teahaz/TH-1-MO/pcb/MO/v0.1/fabrication/impedence_control.xlsx

Signal Layer | Reference Layer | Impedance Type | Trace Width（mil) | Trace Spacing（mil) | Impedance(ohm)±10% | Position | Notes
L1 | L2 | Differential Pair (Non coplanar) | 4.688 | 7.87 | 100 |  | 5 Separate pairs
L1 | L2 | Differential Pair (Non coplanar) | 5.338 | 5.909 | 90 |  | 5 Separate pairs
L1/L4 | L2/L3 | Differential Pair (Non coplanar) | 5.338 | 5.909 | 90 |  | USB HS differential pairs transition layers via through-hole vias partway along their length: L1 (ref L2) → L4 (ref L3). Same trace width/spacing (5.338/5.909 mil) maintained on both segments. L3 is locally flooded with GND (via-stitched to main ground) beneath the L4 segments, with a brief interruption under the connector. Screenshot shows both segments and the via connecting them. 2 differential pairs.
