teahaz/TH-1-MO/parts/p20/assembly.FCStd

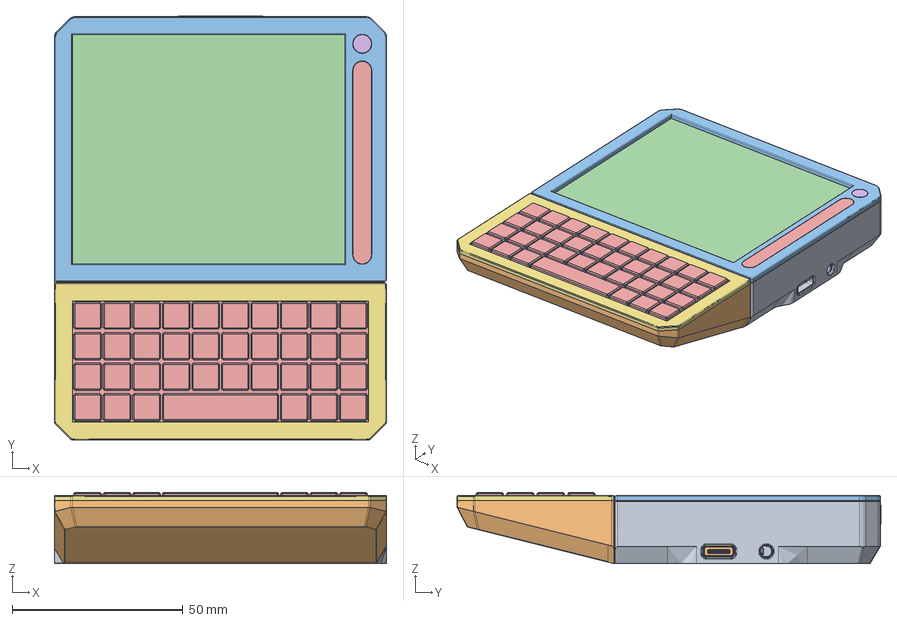
[picture p1: CAD file, 2026-10-23]
parts/p20/assembly.FCStd
97.4 x 124.3 x 20.9 mm
StockShell
StudyCase
Bezel
Screen
LEDDiffuser
IRWindow
StockCarrier
RuntimeCM5
RuntimeCM5Seats
StockCooling
StockFFC
StockDisplayBond
StockIRHarness
IRBoard
IRRx
IRTx
IRBaffle
PCB
SwitchBodies
SwitchActuators
TPUKeymat
LongKeyInsert
RetainingFrame
LEDStrip
LEDs
LEDConnector
LEDPlug
LEDWires
DisplaySocketBody
DisplaySocketLatch
DisplaySocketContacts
Card0
Card1
Card0USB
Card1USB
Card0Plug
Card1Plug
AudioBody
AudioFlex
USBPads
RightUSBShell
RightUSBInsulator
RightUSBContacts
Host0Shell
Host0Insulator
Host0Contacts
Host1Shell
Host1Insulator
Host1Contacts
PScrew0
PScrew1
PNut0
PNut1
PSeatPad0
PSeatPad1
KScrew0
KScrew1
KNut0
KNut1
KSeatPad0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
