teahaz/TH-1-MO/parts/p22/exterior-print/assembly.FCStd

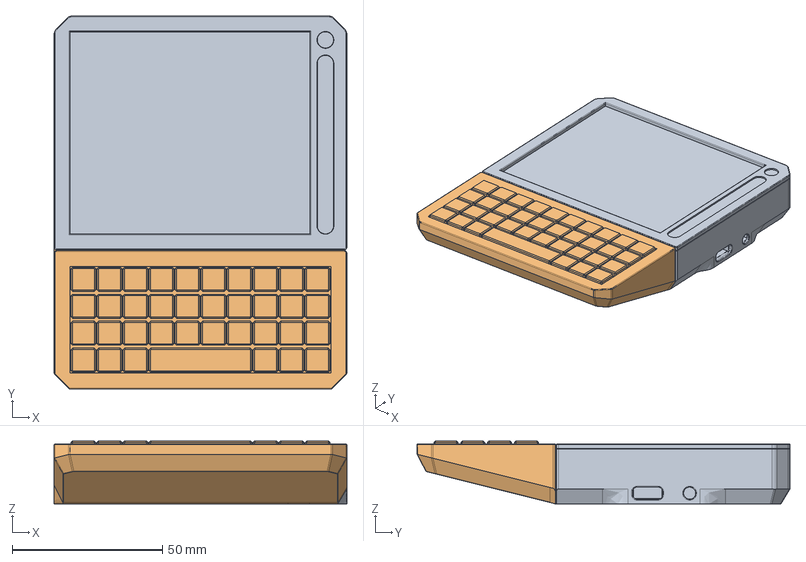
[picture p2: CAD file, 2026-10-23]
parts/p22/exterior-print/assembly.FCStd
97.4 x 124.1 x 20.9 mm
Puck
Keyboard
