teahaz/TH-1-MO/parts/p19/assembled.step

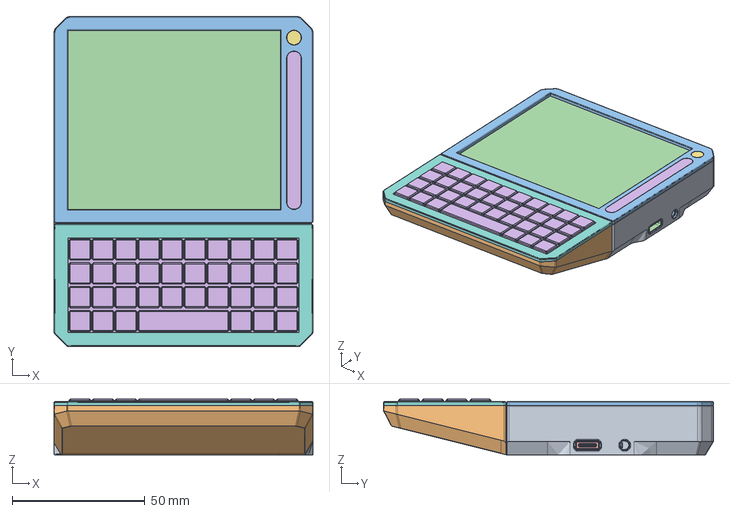
[picture p3: CAD file, 2026-10-19]
parts/p19/assembled.step
97.4 x 124.1 x 20.9 mm
