teahaz/TH-1-MO/parts/p12/stl/03_hat_with_antennae.stl

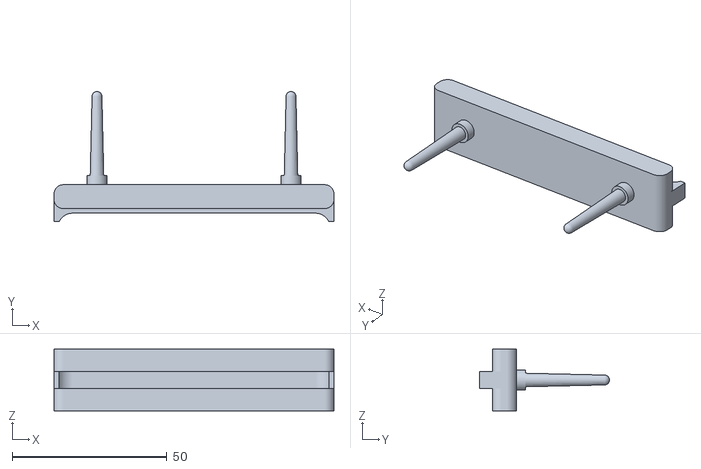
[picture p4: CAD file, 2026-10-11]
parts/p12/stl/03_hat_with_antennae.stl
90.4 x 42.0 x 20.0
