teahaz/TH-1-MO/parts/p15/P15.FCStd

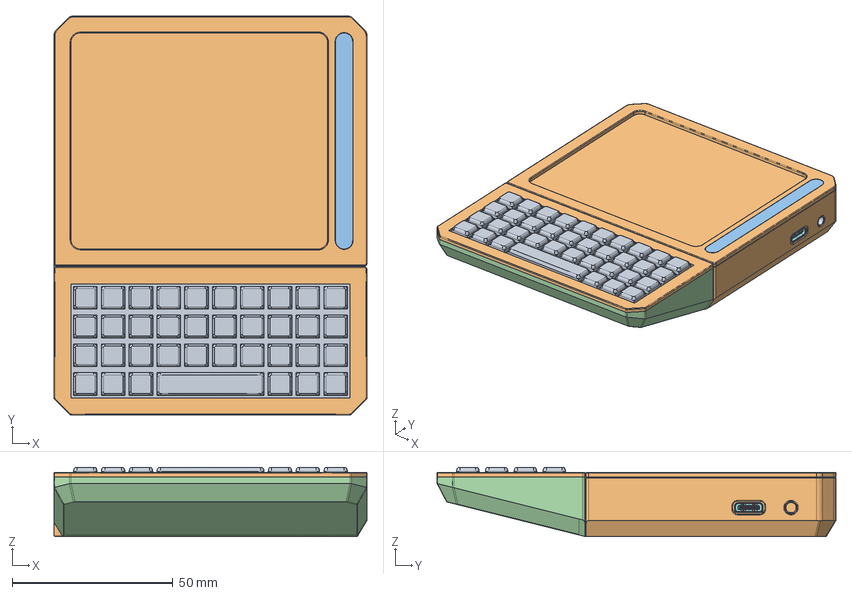
[picture p5: CAD file, 2026-10-19]
parts/p15/P15.FCStd
97.4 x 124.1 x 21.5 mm
Puck shell
Bezel
Screen
Card0
Card1
Card0USB
Card1USB
FixedUSB
AudioJack
Puck
Flush white diffuser (mounting and electronics TBD)
Case
PCB
SwitchBodies
SwitchActuators
LongKeyInsert
TPUKeymat
RetainingFrame
