teahaz/TH-1-MO/parts/p15/stl/06_led_diffuser.stl

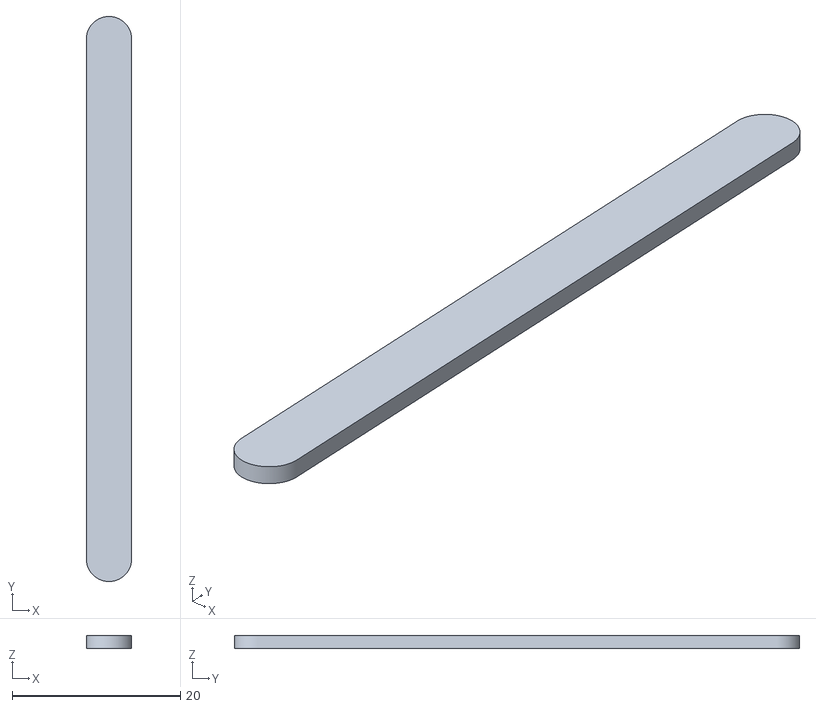
[picture p6: CAD file, 2026-10-19]
parts/p15/stl/06_led_diffuser.stl
5.40 x 67.2 x 1.50
