teahaz/TH-1-MO/parts/p16/P16.FCStd

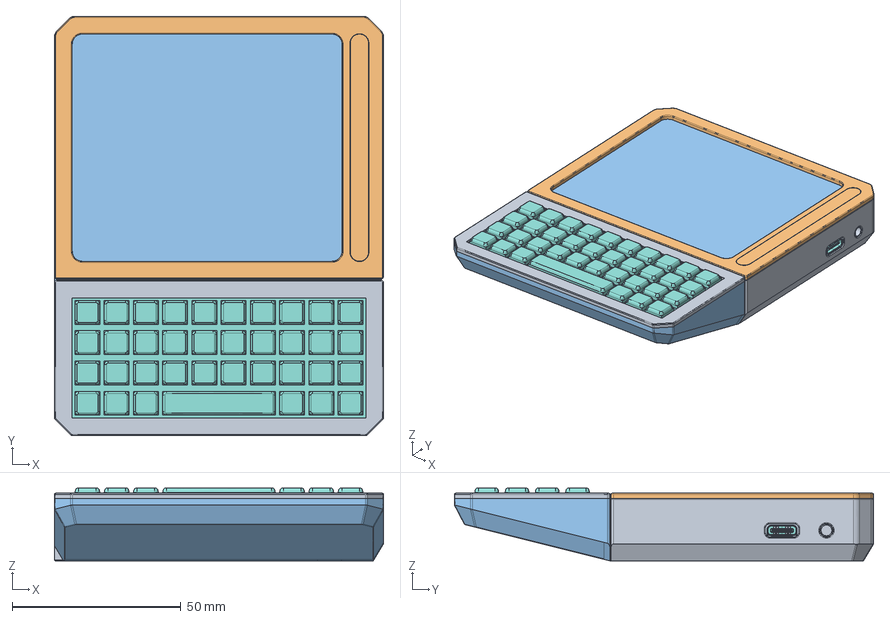
[picture p7: CAD file, 2026-10-19]
parts/p16/P16.FCStd
97.4 x 124.1 x 21.5 mm
Bezel
Screen
Card0
Card1
Card0USB
Card1USB
FixedUSB
AudioJack
LEDDiffuser
Case
PCB
SwitchBodies
SwitchActuators
LongKeyInsert
TPUKeymat
RetainingFrame
PScrew0
PNut0
PScrew1
PNut1
PHookPad0
PHookPad1
KScrew0
KNut0
KScrew1
KNut1
KHookPad0
KHookPad1
