teahaz/TH-1-MO/parts/p16/stl/05_tpu_keymat.stl

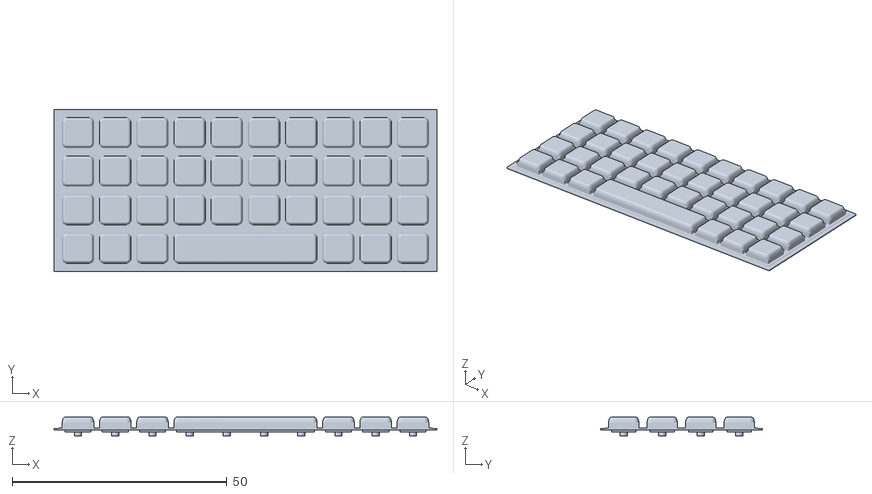
[picture p8: CAD file, 2026-10-19]
parts/p16/stl/05_tpu_keymat.stl
89.1 x 37.8 x 4.35
