teahaz/TH-1-MO/parts/p17/P17.FCStd

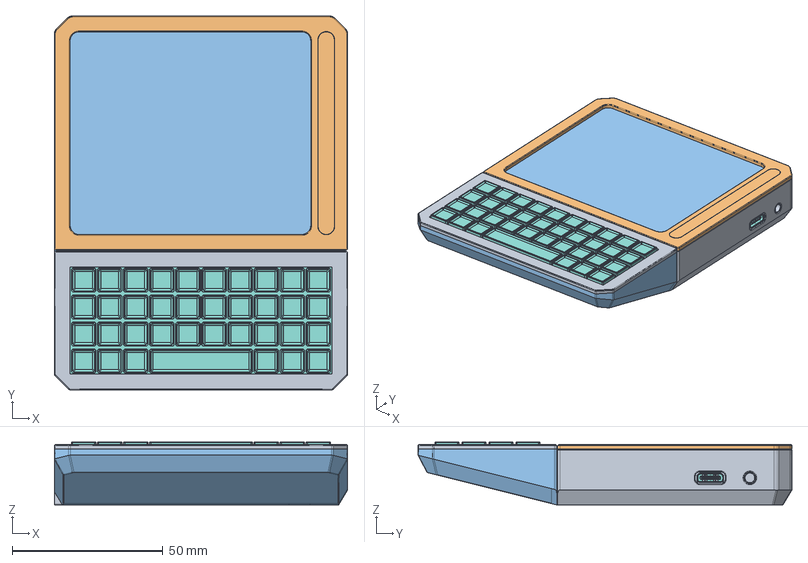
[picture p9: CAD file, 2026-10-19]
parts/p17/P17.FCStd
97.4 x 124.1 x 20.9 mm
Bezel
Screen
Card0
Card1
Card0USB
Card1USB
FixedUSB
AudioJack
LEDDiffuser
Case
PCB
SwitchBodies
SwitchActuators
LongKeyInsert
TPUKeymat
RetainingFrame
PScrew0
PNut0
PScrew1
PNut1
PSeatPad0
PSeatPad1
KScrew0
KNut0
KScrew1
KNut1
KSeatPad0
KSeatPad1
