teahaz/TH-1-MO/parts/p18/stl/05_tpu_keymat.stl

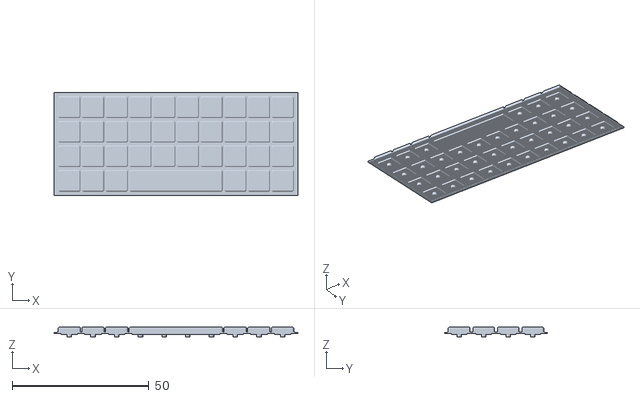
[picture p11: CAD file, 2026-10-19]
parts/p18/stl/05_tpu_keymat.stl
89.1 x 37.8 x 3.75
