teahaz/TH-1-MO/parts/p19/assembled/RetainingFrame.stl

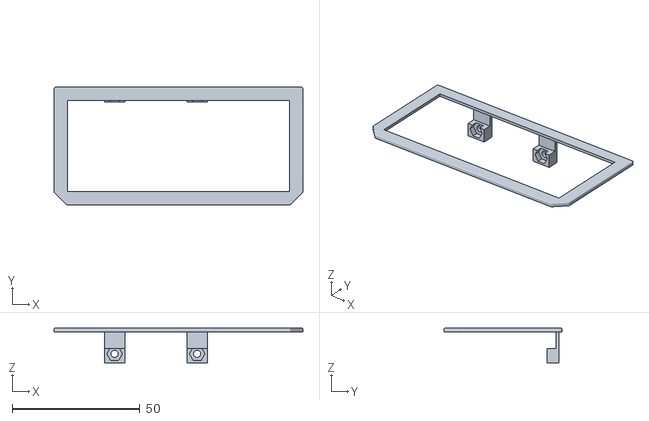
[picture p12: CAD file, 2026-10-19]
parts/p19/assembled/RetainingFrame.stl
97.4 x 46.1 x 13.5
