teahaz/TH-1-MO/parts/p19/internals/PCIePads.stl

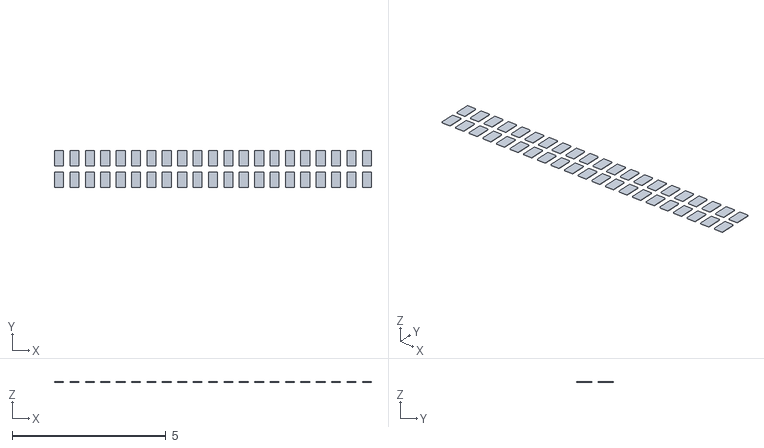
[picture p13: CAD file, 2026-10-19]
parts/p19/internals/PCIePads.stl
10.3 x 1.20 x 0.035
