teahaz/TH-1-MO/parts/p22/exterior-print/print/stl/puck.stl

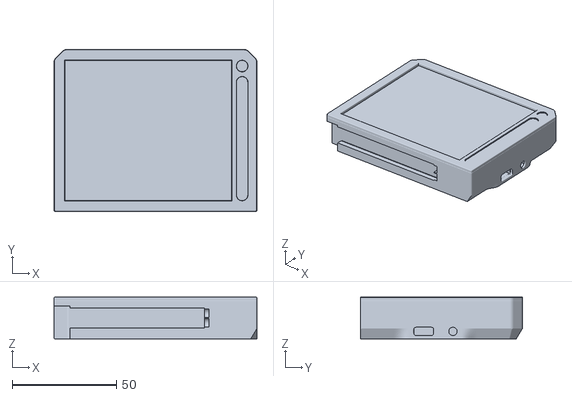
[picture p14: CAD file, 2026-10-23]
parts/p22/exterior-print/print/stl/puck.stl
97.4 x 77.8 x 20.0
