teahaz/TH-1-MO/parts/p15/stl/02_keyboard_case.stl

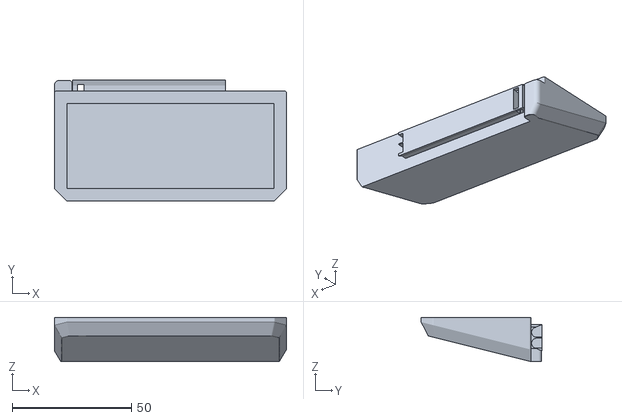
[picture p15: CAD file, 2026-10-19]
parts/p15/stl/02_keyboard_case.stl
97.4 x 50.7 x 18.5
