teahaz/TH-1-MO/parts/p17/stl/01_puck_shell.stl

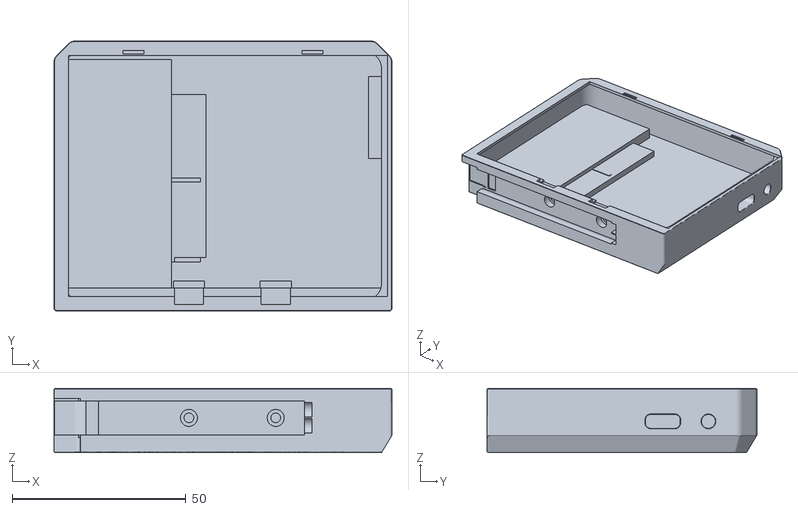
[picture p16: CAD file, 2026-10-19]
parts/p17/stl/01_puck_shell.stl
97.4 x 77.8 x 18.5
