teahaz/TH-1-MO/parts/p18/stl/01_puck_shell.stl

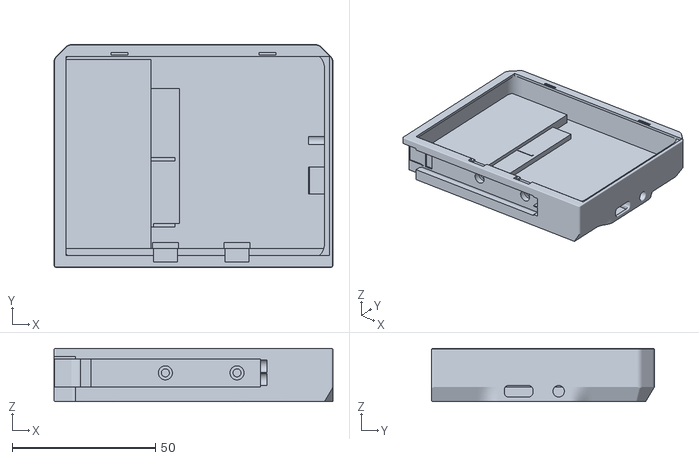
[picture p17: CAD file, 2026-10-19]
parts/p18/stl/01_puck_shell.stl
97.4 x 77.8 x 18.5
