teahaz/TH-1-MO/parts/p19/assembled/NokiaBattery.stl

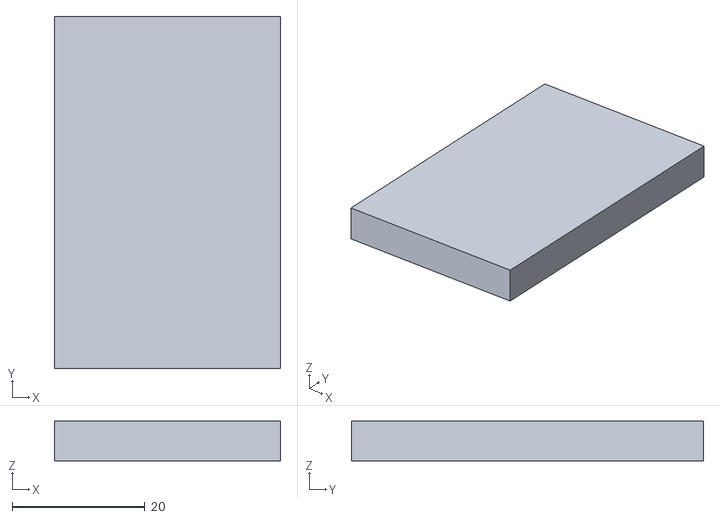
[picture p18: CAD file, 2026-10-19]
parts/p19/assembled/NokiaBattery.stl
34.0 x 53.0 x 6.00
