teahaz/TH-1-MO/parts/p19/internals/RuntimeCM5.stl

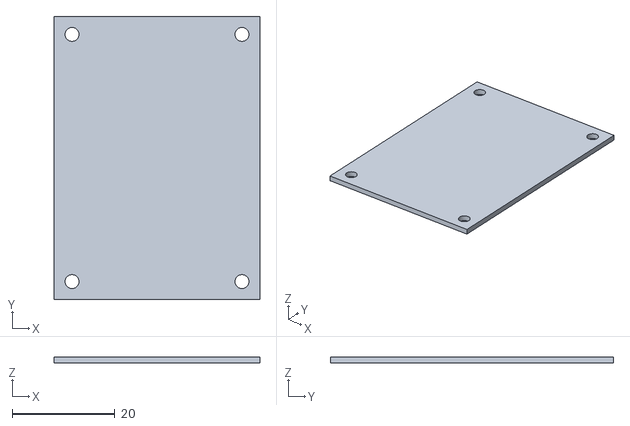
[picture p19: CAD file, 2026-10-19]
parts/p19/internals/RuntimeCM5.stl
40.0 x 55.0 x 1.24
