teahaz/TH-1-MO/parts/p22/exterior-print/print/stl/keyboard.stl

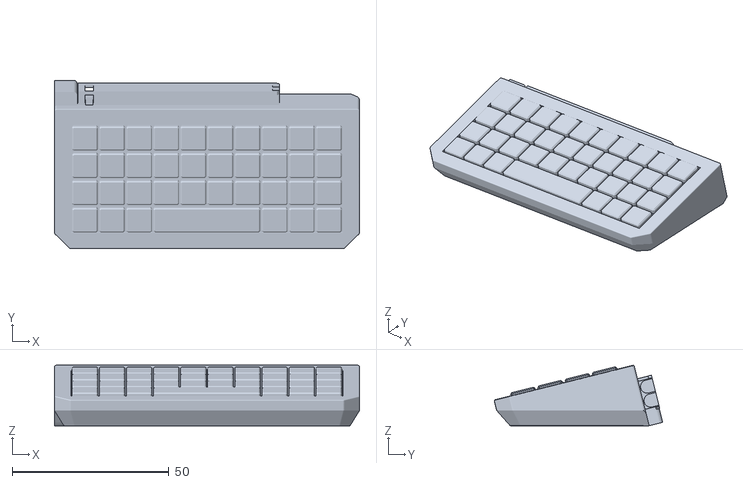
[picture p20: CAD file, 2026-10-23]
parts/p22/exterior-print/print/stl/keyboard.stl
97.4 x 53.8 x 19.4
