teahaz/TH-1-MO/parts/p16/stl/04_keyboard_frame.stl

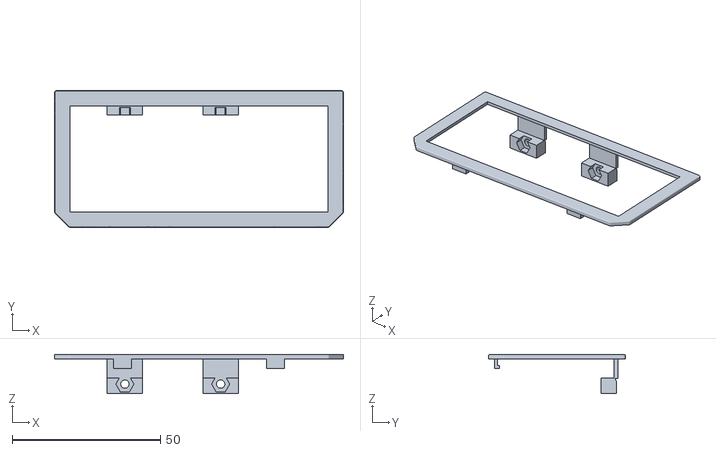
[picture p21: CAD file, 2026-10-19]
parts/p16/stl/04_keyboard_frame.stl
97.4 x 46.1 x 13.2
