teahaz/TH-1-MO/parts/p17/stl/02_puck_bezel.stl

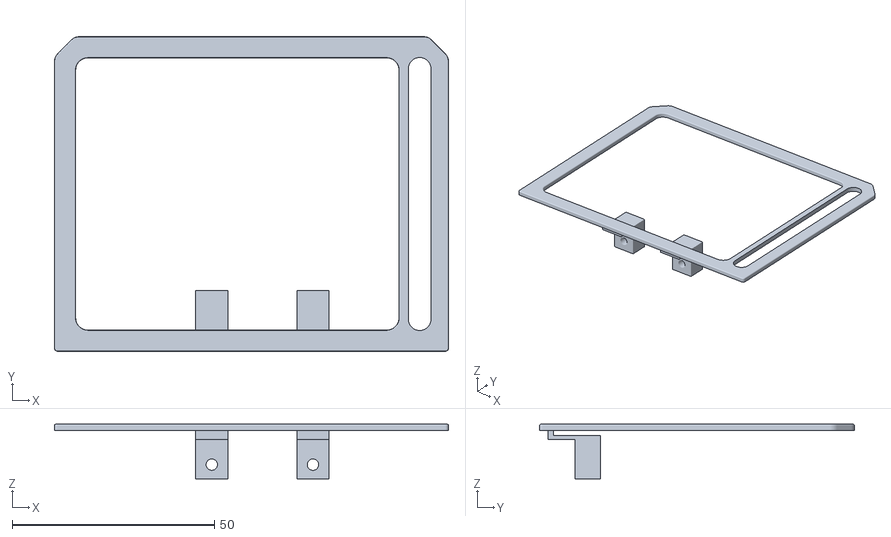
[picture p22: CAD file, 2026-10-19]
parts/p17/stl/02_puck_bezel.stl
97.4 x 77.8 x 13.5
