teahaz/TH-1-MO/parts/p19/assembled/LEDPlug.stl

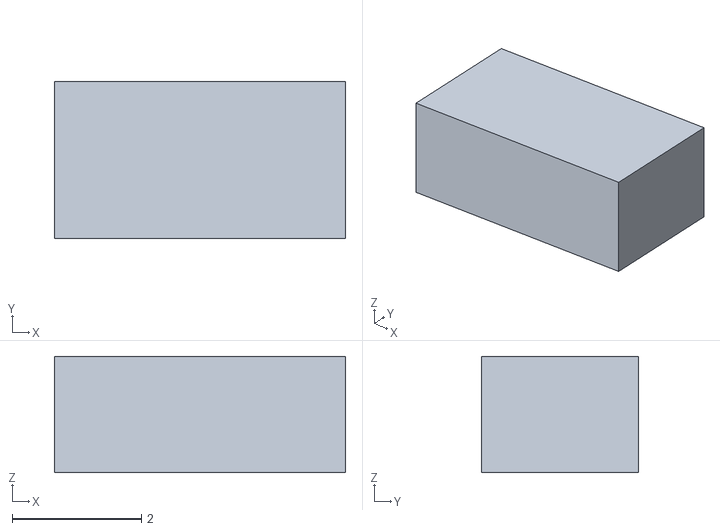
[picture p23: CAD file, 2026-10-19]
parts/p19/assembled/LEDPlug.stl
4.50 x 2.43 x 1.80
