teahaz/TH-1-MO/parts/p19/internals/IRRx.stl

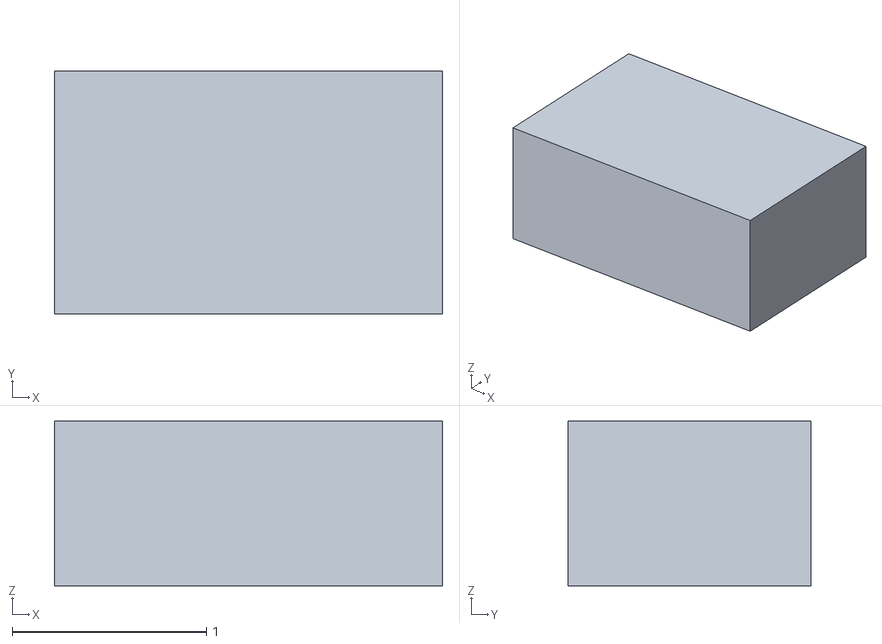
[picture p24: CAD file, 2026-10-19]
parts/p19/internals/IRRx.stl
2.00 x 1.25 x 0.85
