teahaz/TH-1-MO/parts/p19/internals/StockCooling.stl

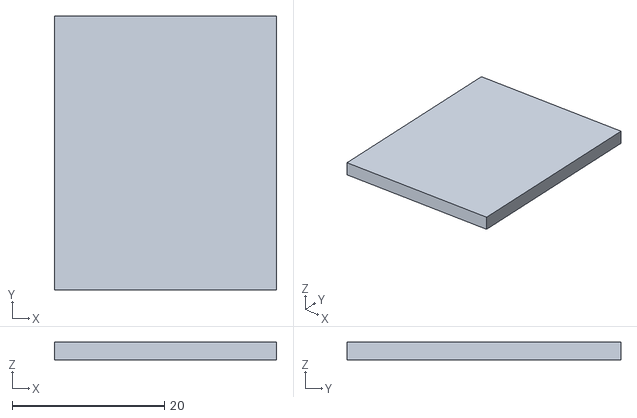
[picture p25: CAD file, 2026-10-19]
parts/p19/internals/StockCooling.stl
29.2 x 36.0 x 2.30
