teahaz/TH-1-MO/parts/p16/stl/02_puck_bezel.stl

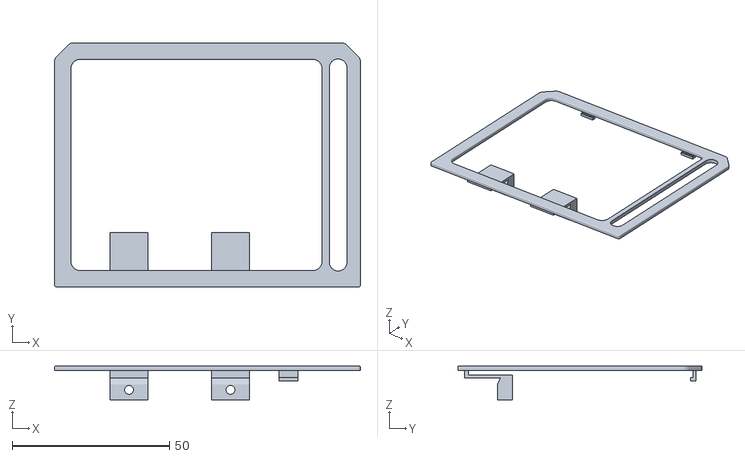
[picture p26: CAD file, 2026-10-19]
parts/p16/stl/02_puck_bezel.stl
97.4 x 77.8 x 10.8
