teahaz/TH-1-MO/parts/p19/assembled/IRWindow.stl

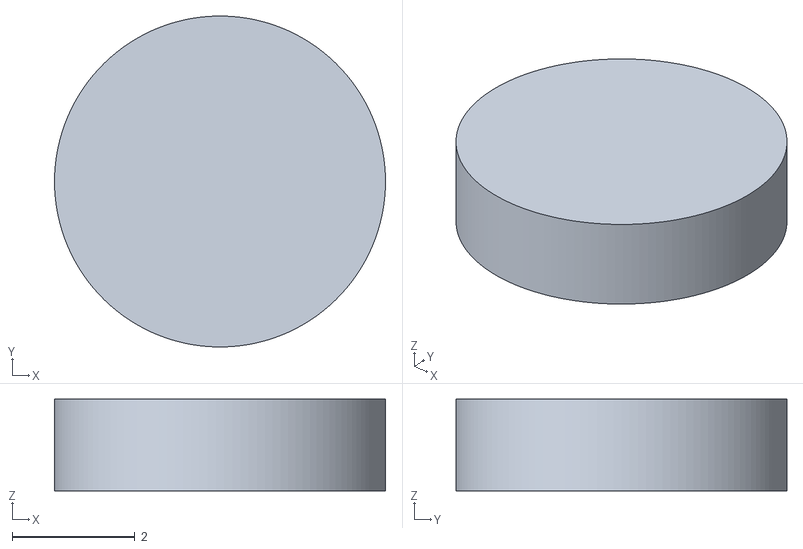
[picture p27: CAD file, 2026-10-19]
parts/p19/assembled/IRWindow.stl
5.40 x 5.40 x 1.50
