teahaz/TH-1-MO/parts/p19/internals/USBPads.stl

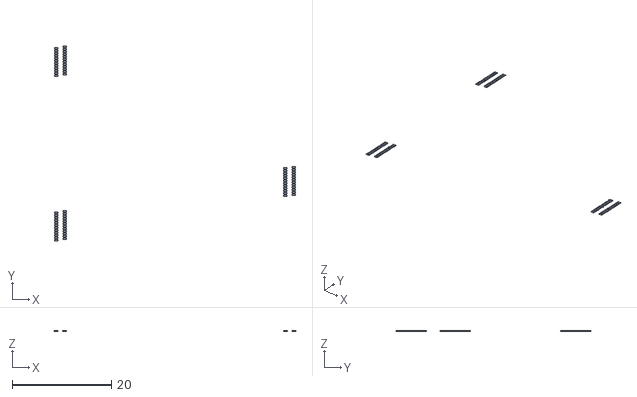
[picture p28: CAD file, 2026-10-19]
parts/p19/internals/USBPads.stl
48.4 x 39.1 x 0.035
