teahaz/TH-1-MO/parts/p19/assembled/Host0Contacts.stl

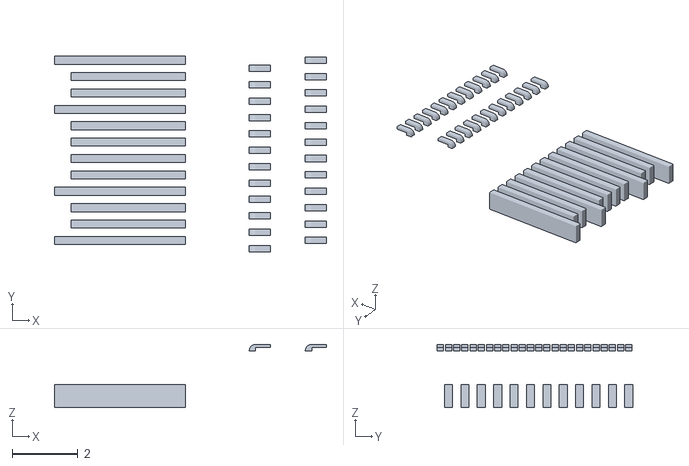
[picture p29: CAD file, 2026-10-19]
parts/p19/assembled/Host0Contacts.stl
8.30 x 5.98 x 1.93
