teahaz/TH-1-MO/parts/p19/internals/StockFFC.stl

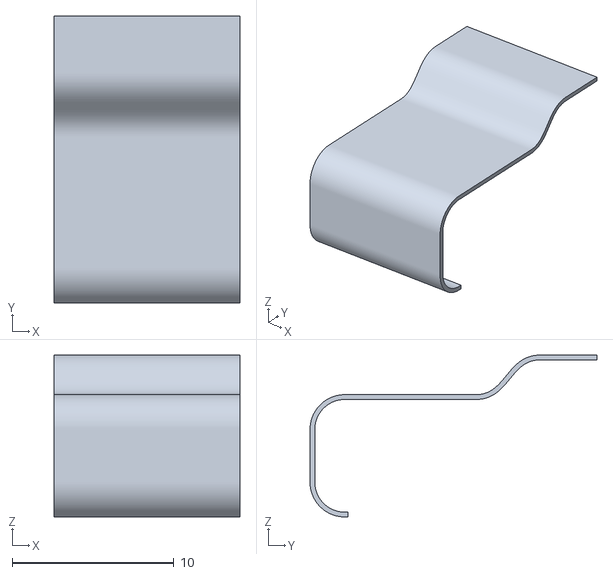
[picture p30: CAD file, 2026-10-19]
parts/p19/internals/StockFFC.stl
11.5 x 17.8 x 10.0
