teahaz/TH-1-MO/parts/p19/assembled/LongKeyInsert.stl

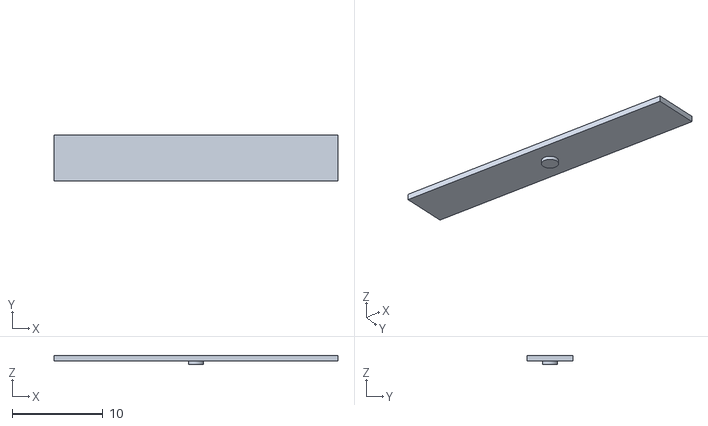
[picture p31: CAD file, 2026-10-19]
parts/p19/assembled/LongKeyInsert.stl
31.4 x 5.09 x 0.95
