teahaz/TH-1-MO/parts/p19/internals/Host1Insulator.stl

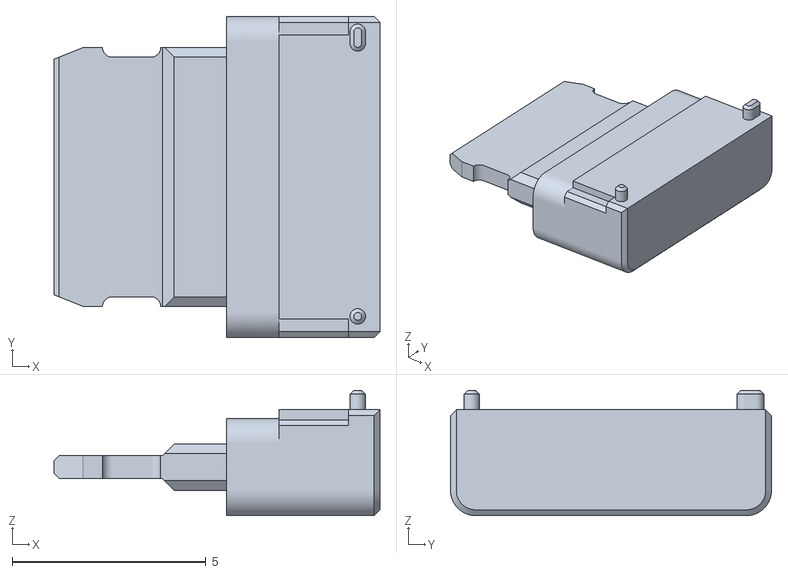
[picture p32: CAD file, 2026-10-19]
parts/p19/internals/Host1Insulator.stl
8.41 x 8.29 x 3.23
