teahaz/TH-1-MO/parts/p19/assembled/Card0.stl

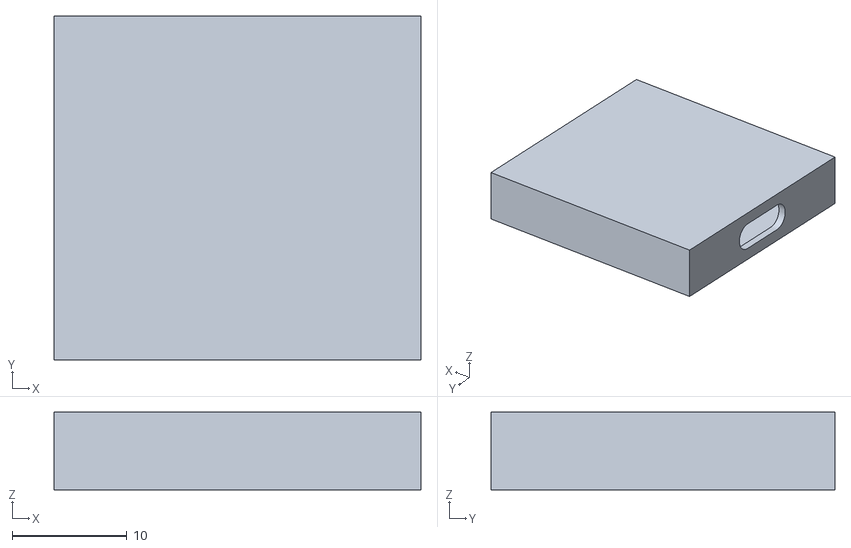
[picture p33: CAD file, 2026-10-19]
parts/p19/assembled/Card0.stl
32.0 x 30.0 x 6.80
