teahaz/TH-1-MO/parts/p19/internals/StockCarrier.stl

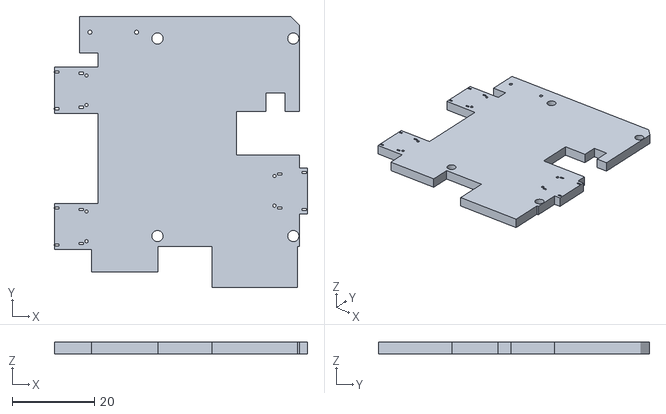
[picture p34: CAD file, 2026-10-19]
parts/p19/internals/StockCarrier.stl
61.6 x 65.8 x 2.88
