teahaz/TH-1-MO/parts/p19/assembled/KNut1.stl

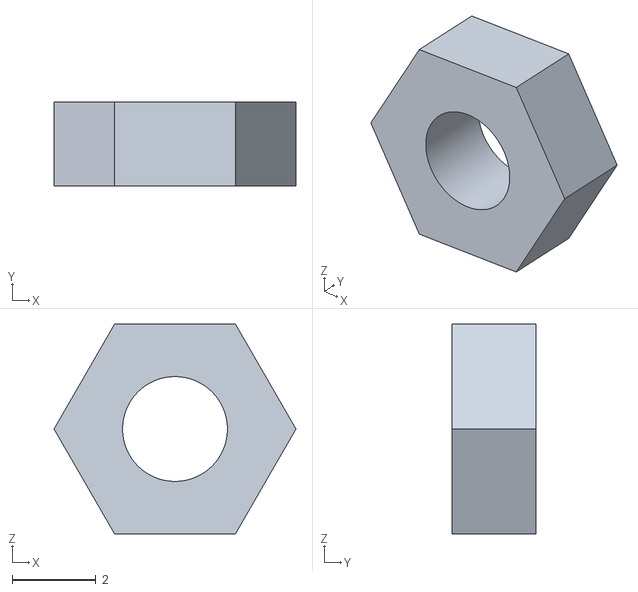
[picture p35: CAD file, 2026-10-19]
parts/p19/assembled/KNut1.stl
5.77 x 2.00 x 5.00
