teahaz/TH-1-MO/parts/p19/internals/Card0Plug.stl

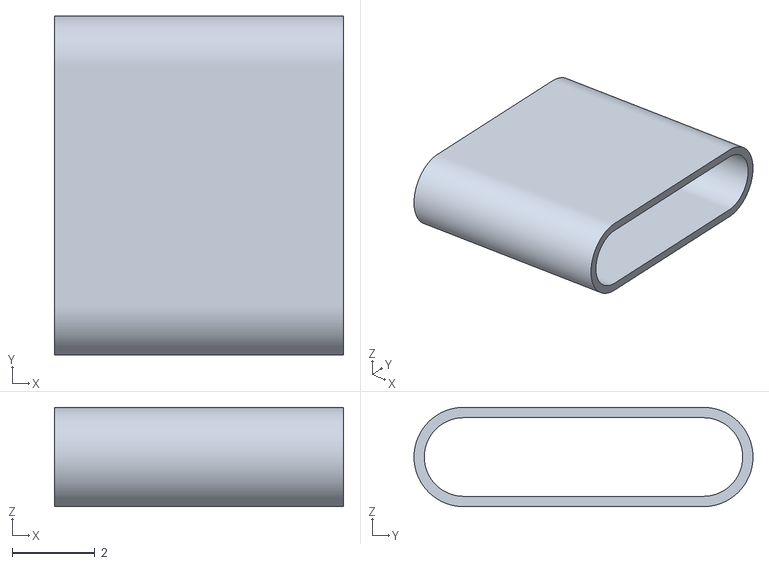
[picture p36: CAD file, 2026-10-19]
parts/p19/internals/Card0Plug.stl
7.00 x 8.20 x 2.40
