teahaz/TH-1-MO/parts/p19/assembled/Host0Shell.stl

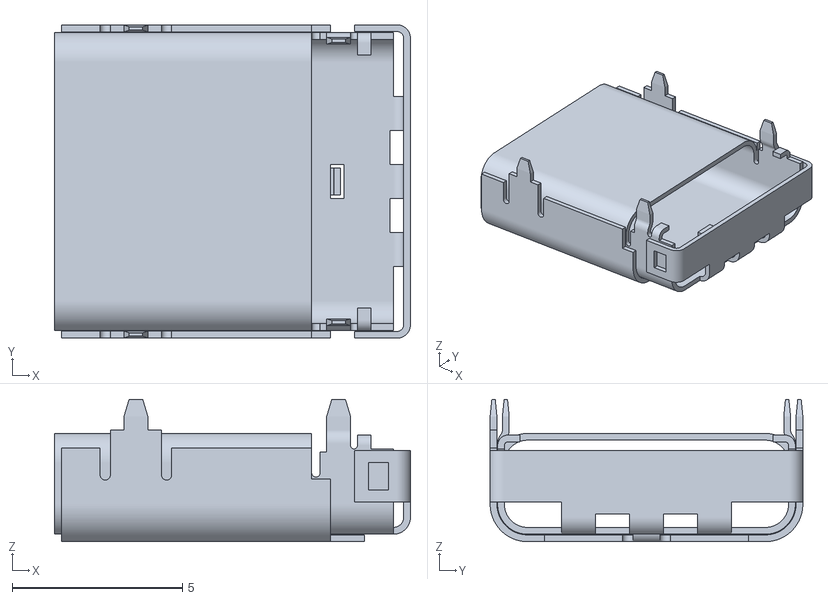
[picture p37: CAD file, 2026-10-19]
parts/p19/assembled/Host0Shell.stl
10.5 x 9.20 x 4.18
