teahaz/TH-1-MO/parts/p19/internals/IRBoard.stl

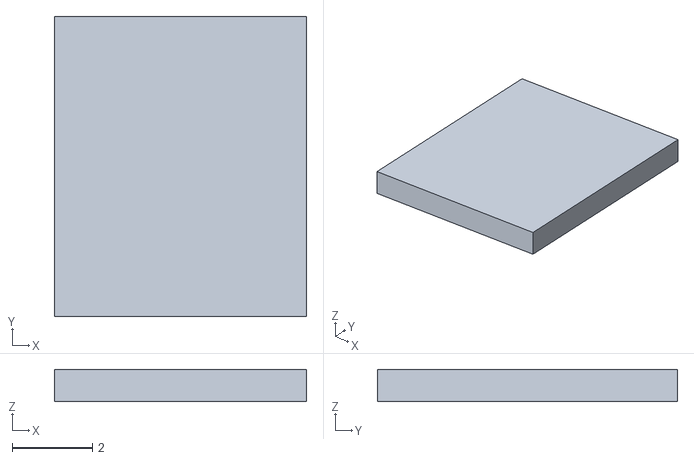
[picture p38: CAD file, 2026-10-19]
parts/p19/internals/IRBoard.stl
6.30 x 7.50 x 0.8
