teahaz/TH-1-MO/parts/p19/assembled/LEDs.stl

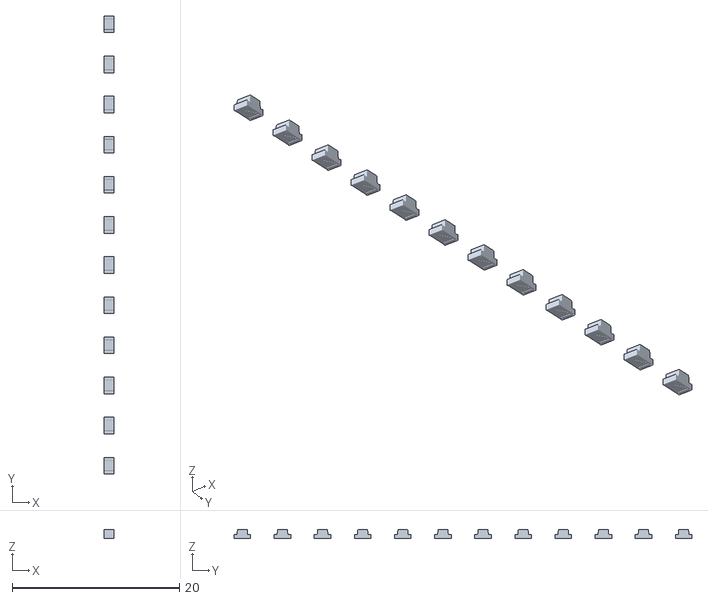
[picture p39: CAD file, 2026-10-19]
parts/p19/assembled/LEDs.stl
1.25 x 54.8 x 1.10
