teahaz/TH-1-MO/parts/p19/internals/KSeatPad1.stl

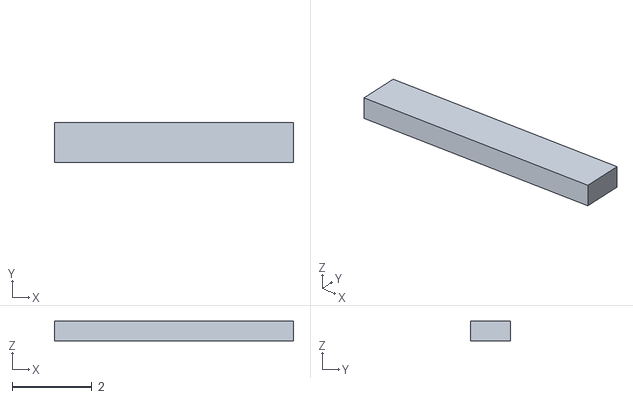
[picture p40: CAD file, 2026-10-19]
parts/p19/internals/KSeatPad1.stl
6.00 x 1.00 x 0.5
