teahaz/TH-1-MO/parts/p19/assembled/AudioBody.stl

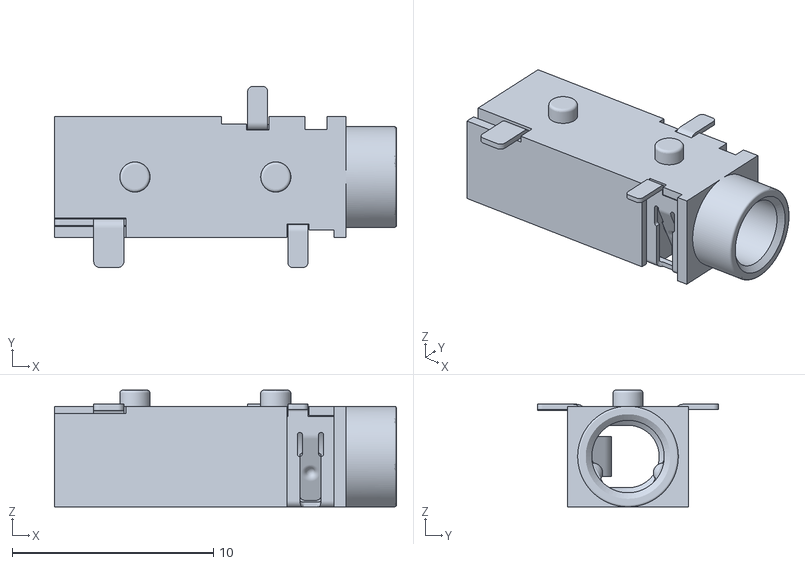
[picture p41: CAD file, 2026-10-19]
parts/p19/assembled/AudioBody.stl
17.0 x 9.00 x 5.80
