teahaz/TH-1-MO/parts/p19/internals/PCIeInsulator.stl

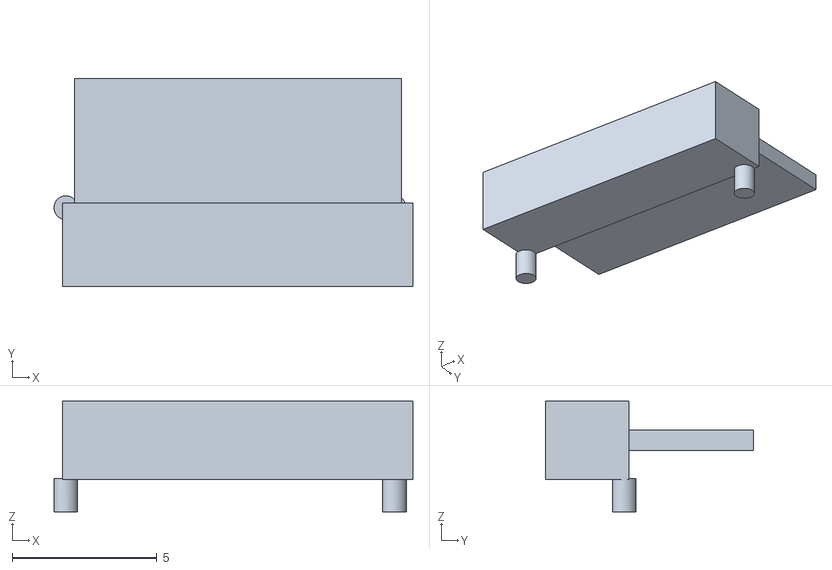
[picture p42: CAD file, 2026-10-19]
parts/p19/internals/PCIeInsulator.stl
12.4 x 7.20 x 3.82
