teahaz/TH-1-MO/parts/p19/assembled/NokiaPad.stl

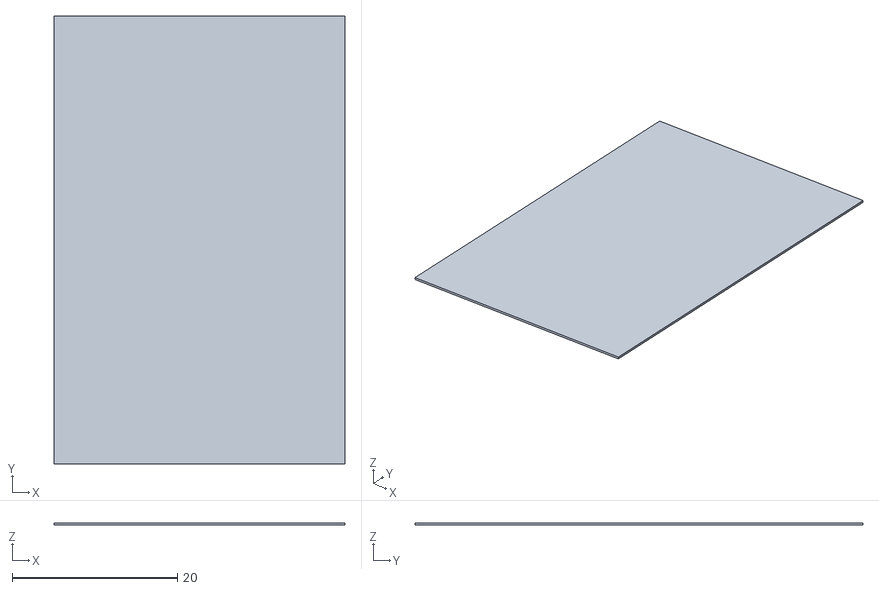
[picture p43: CAD file, 2026-10-19]
parts/p19/assembled/NokiaPad.stl
35.2 x 54.2 x 0.3
