teahaz/TH-1-MO/parts/p19/internals/DisplaySocketContacts.stl

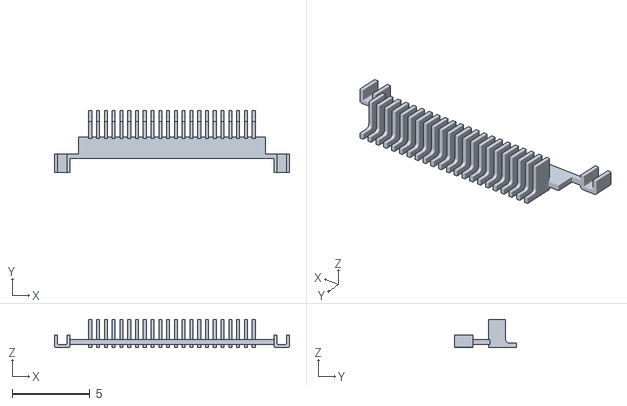
[picture p44: CAD file, 2026-10-19]
parts/p19/internals/DisplaySocketContacts.stl
15.1 x 4.00 x 1.80
