teahaz/TH-1-MO/parts/p19/assembled/Screen.stl

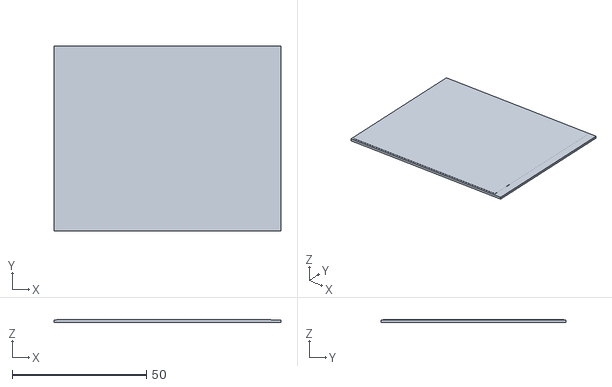
[picture p45: CAD file, 2026-10-19]
parts/p19/assembled/Screen.stl
84.6 x 69.1 x 1.10
