teahaz/TH-1-MO/parts/p19/assembled/LEDDiffuser.stl

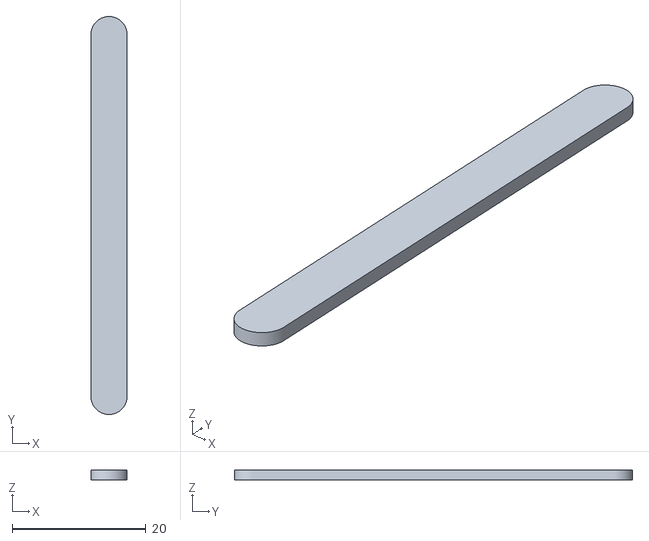
[picture p46: CAD file, 2026-10-19]
parts/p19/assembled/LEDDiffuser.stl
5.40 x 59.4 x 1.50
