teahaz/TH-1-MO/parts/p19/internals/StockIRHarness.stl

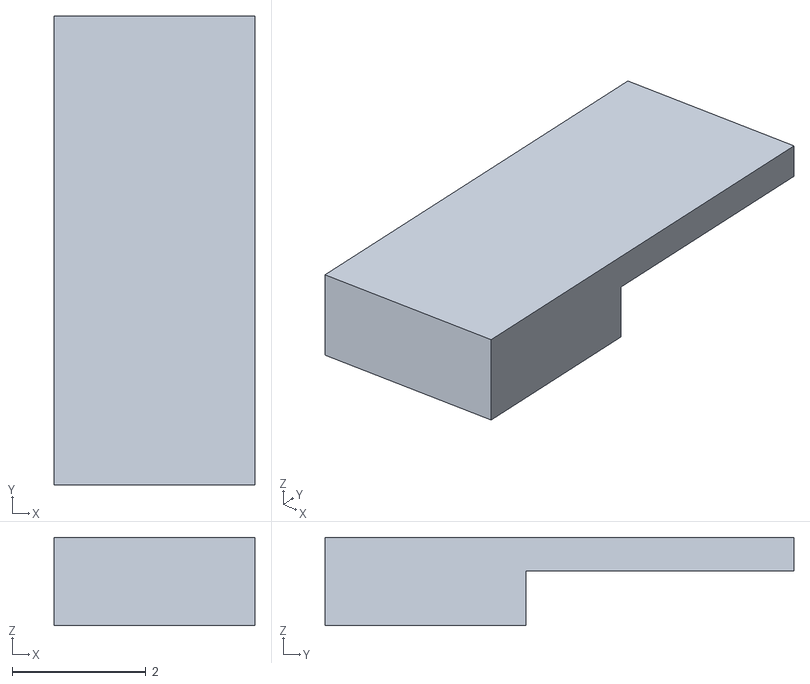
[picture p47: CAD file, 2026-10-19]
parts/p19/internals/StockIRHarness.stl
3.00 x 7.00 x 1.32
