teahaz/TH-1-MO/parts/p1/TH-A1OC_keyboard.scad

// TH-A1OC: Basic keyboard module
include <parts.scad>

translate([CASE_THICKNESS+MODULE_MARGIN, FPT_D, CASE_THICKNESS+MODULE_MARGIN])
    Keyboard();
