teahaz/TH-1-MO/parts/p5/modules/keyboard.scad

KB_W = 80;
KB_D = 6.6;
KB_H = 50;

module _kb_stl() {
    mirror([0, 0, 0])
        rotate([90, 0, 0])
        translate([-25, 87, 0])
        color("#343434")
        import("modules/keyboard.stl", $fn=2);
}

module Keyboard(space=0, cutout=false) {
    align = space == 0 ? 0 : (space - KB_W) / 2;

    translate([align, 1.6, 0]) {
        if (cutout) cube([KB_W, KB_D, KB_H]);
        else _kb_stl();
    }
}
