teahaz/TH-1-MO/parts/p1/TH-A1OC_all.scad

// TH-A1OC: All parts for debug prints
include <parts.scad>

SOLID_SHELL = true;

include <TH-A1OC_shell.scad>
include <TH-A1OC_core.scad>
include <TH-A1OC_frontplate.scad>
include <TH-A1OC_keyboard.scad>
include <TH-A1OC_modules.scad>

Externals(fw=false);
