teahaz/TH-1-MO/parts/p1/TH-A1OC_core.scad

// TH-A1OC: Core (inner shell)
include <parts.scad>

render() difference() {
    union() {
        Internals();
    }
    Externals(cutout=true);
    ExpansionBay(cutout=true);
}
