teahaz/TH-1-MO/parts/p1/TH-A1OC_frontplate.scad

// TH-A1OC: Frontplate
include <parts.scad>

color("white") translate([CASE_THICKNESS, e, CASE_THICKNESS]) Frontplate();
