teahaz/TH-1-MO/(list of files, cad)

Other CAD files:
parts/p21/assembly.FCStd
parts/p22/assembly.FCStd
parts/p18/P18.FCStd
parts/p19/P19.FCStd
parts/p16/stl/03_keyboard_case.stl
parts/p15/stl/04_tpu_keymat.stl
parts/p16/stl/01_puck_shell.stl
parts/p19/assembled/StockShell.stl
parts/p19/internals/Card1Plug.stl
parts/p19/assembled/KSeatPad0.stl
parts/p19/internals/PSeatPad1.stl
parts/p19/assembled/RightUSBShell.stl
parts/p19/assembled/Host1Shell.stl
parts/p19/internals/RightUSBInsulator.stl
parts/p19/assembled/Card1.stl
parts/p4/TH1-MO.scad
parts/p1/TH-A1OC_scratch.scad
parts/p0/comm_v0.scad
parts/p0/comm_v1.scad
parts/p19/assembled/PScrew0.stl
parts/p19/internals/KScrew1.stl
parts/p2/modules/common.scad
parts/p2/modules/framework.scad
parts/p2/modules/keyboard.scad
parts/p2/modules/screen.scad
parts/p22/exterior-print/stl/keyboard.stl
parts/p22/exterior-print/stl/puck.stl
parts/p3/modules/body.scad
parts/p3/modules/common.scad
parts/p3/modules/framework.scad
parts/p3/modules/keyboard.scad
parts/p4/modules/body.scad
parts/p4/modules/framework.scad
parts/p4/modules/keyboard.scad
