teahaz/TH-1-MO/debug_board/pcb/v0.1/notes.md

# Possible extra pins

- [ ] 3v3 PI
    if there is no other way for the harness to know that the pi is on.

- [ ] NRF
    Anything that could bridge on the nrf and could not be easily tested for in firmware
