teahaz/TH-1-MO/firmware/ports/bus_replay/host/ui/session/session.c

/*
 * The session (ui/session/session.h). The UI thread and the session thread share the
 * command queue, the status, the events, the decoder list and the current view, under
 * lock. Everything else belongs to the session thread: the capture, the batch, and the
 * decoder groups' codec sessions.
 */

#include <errno.h>
#include <pthread.h>
#include <stdbool.h>
#include <stddef.h>
#include <stdint.h>
#include <stdio.h>
#include <stdlib.h>
#include <string.h>
#include <time.h>

#include "capture/board.h"
#include "capture/capture.h"
#include "capture/control.h"
#include "capture/dummy.h"
#include "capture/info.h"
#include "capture/remote.h"
#include "capture/thcfile.h"
#include "codec/codec.h"
#include "codec/item.h"
#include "common/capture_info.h"
#include "common/record.h"
#include "common/status.h"
#include "ui/session/items.h"
#include "ui/session/session.h"
#include "ui/store/store.h"


#define EVENTS_MAX 256
#define STACKED_MAX 8
#define FED_MAX 64
#define READ_MAX 4096
#define IDLE_MS 50
#define PULL_MS 10
#define LATE_S 2
#define KNOWN_LINES 64

enum cmd_type {
    CMD_OPEN,
    CMD_HELLO,
    CMD_START,
    CMD_STOP,
    CMD_RECORD,
    CMD_CLOSE,
    CMD_DECODER_ADD,
    CMD_DECODER_REMOVE,
};

// A command, with copies of everything it was given.
struct cmd {
    uint64_t id;
    enum cmd_type type;
    enum session_backend backend;
    bool realtime;
    bool have_path;
    char path[512];
    struct session_config cfg;
    uint8_t set[64];
    bool have_set;
    char name[SESSION_LABEL_MAX];
    char args[SESSION_ARGS_MAX];
    char on[SESSION_LABEL_MAX];
    double hold;
    struct cmd *next;
};

// A view and what it owns. refs counts the session's hold on it and every acquire.
struct view {
    struct session_view v;
    unsigned int refs;
    struct hello hello;
    bool have_hello;
    struct capture_info info;
    bool have_info;
};

// A loss the store has and the group has not been given yet, with its counts.
struct known {
    struct store_loss loss;
    bool fed;
    uint32_t lost[KNOWN_LINES];
};

// A decoder as the UI gave it.
struct dec_spec {
    char name[SESSION_LABEL_MAX];
    char args[SESSION_ARGS_MAX];
};

/*
 * A decoder group, in the session thread. specs[0] is its protocol decoder, the rest are
 * stacked on it. With a capture, codec decodes it: pos are its merged read positions, skip
 * the tick its records start after, decoded how far it has gone, fed the losses given.
 */
struct group {
    uint32_t id;
    char label[SESSION_LABEL_MAX];
    struct dec_spec specs[STACKED_MAX];
    size_t spec_count;
    double hold;

    struct codec *codec;
    uint64_t *pos;
    bool started;
    uint64_t skip;
    bool have_decoded;
    uint64_t decoded;
    struct store_loss fed[FED_MAX];
    size_t fed_len;
    struct known known[FED_MAX];
    size_t known_len;
    uint16_t n;
    struct record pend[READ_MAX];
    size_t pend_len;
    uint64_t next_level;
    int error;
    char text[SESSION_TEXT_MAX];
};

struct session {
    pthread_t thread;
    pthread_mutex_t lock;
    pthread_cond_t wake;
    bool quit;
    struct session_options opt;

    // Under lock.
    struct cmd *head;
    struct cmd *tail;
    uint64_t next_id;
    unsigned int running_cmds;
    struct session_status st;
    struct session_event events[EVENTS_MAX];
    uint64_t event_count;
    struct session_decoder decs[SESSION_DECODERS_MAX];
    size_t dec_count;
    struct view *cur;
    uint64_t gen;

    // The session thread's.
    struct capture *cap;
    enum session_backend backend;
    bool realtime;
    char path[512];
    bool have_path;
    bool reading;
    char record[512];
    bool record_set;
    struct store_batch *batch;
    struct store *store;
    struct items *items;
    const struct capture_info *info;
    struct group groups[SESSION_DECODERS_MAX];
    size_t group_count;
    uint32_t next_group;
    bool catching_up;
};


static void *session_main(void *arg);
static int64_t queue(struct session *s, struct cmd *c);
static void run(struct session *s, struct cmd *c);
static void done(struct session *s, const struct cmd *c, int result, const char *text);
static int backend_open(struct session *s, char *text, size_t size);
static void backend_close(struct session *s);
static int capture_begin(struct session *s);
static void capture_ended(struct session *s);
static int view_new(struct session *s, bool with_capture);
static void view_put(struct view *v);
static int group_add(struct session *s, const struct cmd *c, char *text, size_t size);
static int group_remove(struct session *s, const char *label);
static int group_start(struct session *s, struct group *g);
static void group_stop(struct group *g);
static bool group_step(struct session *s, struct group *g);
static void groups_publish(struct session *s);
static void status_publish(struct session *s);
static void event_add(struct session *s, uint64_t time, uint16_t code, uint16_t channel,
                      const char *text);
static void on_record(void *ctx, const struct record *r);
static void on_heartbeat(void *ctx, const struct heartbeat *hb);
static void on_loss(void *ctx, const struct loss *loss);
static void on_event(void *ctx, uint16_t code, uint16_t channel, const uint8_t *data,
                     size_t len);
static void label_of(const char *name, const char *args, char *out, size_t size);


int session_new(struct session **out, const struct session_options *opt)
{
    struct session *s = calloc(1, sizeof(*s));
    int err = 0;

    if (!s) {
        return -ENOMEM;
    }
    if (opt) {
        s->opt = *opt;
    }
    s->next_id = 1;
    s->next_group = 1;
    pthread_mutex_init(&s->lock, NULL);
    pthread_cond_init(&s->wake, NULL);
    err = -pthread_create(&s->thread, NULL, session_main, s);
    if (err < 0) {
        pthread_cond_destroy(&s->wake);
        pthread_mutex_destroy(&s->lock);
        free(s);
        return err;
    }
    *out = s;

    return 0;
}


// Stops the thread, closes the backend (a running capture is stopped) and frees it all.
void session_free(struct session *s)
{
    if (!s) {
        return;
    }
    pthread_mutex_lock(&s->lock);
    s->quit = true;
    pthread_cond_signal(&s->wake);
    pthread_mutex_unlock(&s->lock);
    pthread_join(s->thread, NULL);

    while (s->head) {
        struct cmd *c = s->head;

        s->head = c->next;
        free(c);
    }
    if (s->cur) {
        view_put(s->cur);
    }
    pthread_cond_destroy(&s->wake);
    pthread_mutex_destroy(&s->lock);
    free(s);
}


int64_t session_open(struct session *s, const struct session_open *o)
{
    struct cmd *c = calloc(1, sizeof(*c));

    if (!c) {
        return -ENOMEM;
    }
    c->type = CMD_OPEN;
    c->backend = o->backend;
    c->realtime = o->realtime;
    if (o->path) {
        c->have_path = true;
        snprintf(c->path, sizeof(c->path), "%s", o->path);
    }

    return queue(s, c);
}


int64_t session_hello(struct session *s)
{
    struct cmd *c = calloc(1, sizeof(*c));

    if (!c) {
        return -ENOMEM;
    }
    c->type = CMD_HELLO;

    return queue(s, c);
}


int64_t session_start(struct session *s, const struct session_config *cfg)
{
    struct cmd *c = calloc(1, sizeof(*c));

    if (!c) {
        return -ENOMEM;
    }
    if (cfg && cfg->enabled && cfg->set_size > sizeof(c->set)) {
        free(c);
        return -EINVAL;
    }
    c->type = CMD_START;
    if (cfg) {
        c->cfg = *cfg;
        if (cfg->enabled) {
            memcpy(c->set, cfg->enabled, cfg->set_size);
            c->have_set = true;
        }
    }

    return queue(s, c);
}


int64_t session_stop(struct session *s)
{
    struct cmd *c = calloc(1, sizeof(*c));

    if (!c) {
        return -ENOMEM;
    }
    c->type = CMD_STOP;

    return queue(s, c);
}


int64_t session_record(struct session *s, const char *path)
{
    struct cmd *c = calloc(1, sizeof(*c));

    if (!c) {
        return -ENOMEM;
    }
    c->type = CMD_RECORD;
    snprintf(c->path, sizeof(c->path), "%s", path ? path : "");

    return queue(s, c);
}


int64_t session_close(struct session *s)
{
    struct cmd *c = calloc(1, sizeof(*c));

    if (!c) {
        return -ENOMEM;
    }
    c->type = CMD_CLOSE;

    return queue(s, c);
}


int64_t session_decoder_add(struct session *s, const char *name, const char *args,
                            const char *on, double hold)
{
    struct cmd *c = calloc(1, sizeof(*c));

    if (!c) {
        return -ENOMEM;
    }
    if (!name || strlen(name) >= sizeof(c->name) || (args && strlen(args) >= sizeof(c->args)) ||
        (on && strlen(on) >= sizeof(c->on))) {
        free(c);
        return -EINVAL;
    }
    c->type = CMD_DECODER_ADD;
    snprintf(c->name, sizeof(c->name), "%s", name);
    snprintf(c->args, sizeof(c->args), "%s", args ? args : "");
    snprintf(c->on, sizeof(c->on), "%s", on ? on : "");
    c->hold = hold;

    return queue(s, c);
}


int64_t session_decoder_remove(struct session *s, const char *label)
{
    struct cmd *c = calloc(1, sizeof(*c));

    if (!c) {
        return -ENOMEM;
    }
    if (!label || strlen(label) >= sizeof(c->name)) {
        free(c);
        return -EINVAL;
    }
    c->type = CMD_DECODER_REMOVE;
    snprintf(c->name, sizeof(c->name), "%s", label);

    return queue(s, c);
}


void session_status(struct session *s, struct session_status *st)
{
    pthread_mutex_lock(&s->lock);
    *st = s->st;
    st->busy = s->head || s->running_cmds;
    st->gen = s->cur ? s->cur->v.gen : 0;
    st->events = s->event_count;
    pthread_mutex_unlock(&s->lock);
}


size_t session_events(struct session *s, uint64_t after, struct session_event *out, size_t max)
{
    size_t n = 0;

    pthread_mutex_lock(&s->lock);
    for (uint64_t seq = after + 1; seq <= s->event_count && n < max; seq++) {
        if (s->event_count - seq < EVENTS_MAX) {
            out[n++] = s->events[(seq - 1) % EVENTS_MAX];
        }
    }
    pthread_mutex_unlock(&s->lock);

    return n;
}


size_t session_decoders(struct session *s, struct session_decoder *out, size_t max)
{
    size_t n = 0;

    pthread_mutex_lock(&s->lock);
    for (; n < s->dec_count && n < max; n++) {
        out[n] = s->decs[n];
    }
    pthread_mutex_unlock(&s->lock);

    return n;
}


struct session_view *session_acquire(struct session *s)
{
    struct session_view *v = NULL;

    pthread_mutex_lock(&s->lock);
    if (s->cur) {
        s->cur->refs++;
        v = &s->cur->v;
    }
    pthread_mutex_unlock(&s->lock);

    return v;
}


void session_release(struct session *s, struct session_view *v)
{
    if (!v) {
        return;
    }
    pthread_mutex_lock(&s->lock);
    view_put((struct view *)v);
    pthread_mutex_unlock(&s->lock);
}


/*
 * The session thread: runs the commands, then pulls from the backend into the store and
 * lets every group decode a step, and waits only when there is nothing to do.
 */
static void *session_main(void *arg)
{
    struct session *s = arg;

    for (;;) {
        struct cmd *c = NULL;
        bool work = false;

        pthread_mutex_lock(&s->lock);
        if (s->quit) {
            pthread_mutex_unlock(&s->lock);
            break;
        }
        c = s->head;
        if (c) {
            s->head = c->next;
            if (!s->head) {
                s->tail = NULL;
            }
            s->running_cmds++;
        }
        pthread_mutex_unlock(&s->lock);
        if (c) {
            run(s, c);
            pthread_mutex_lock(&s->lock);
            s->running_cmds--;
            pthread_mutex_unlock(&s->lock);
            free(c);
            continue;
        }

        if (s->cap && s->reading) {
            int n = capture_pull(s->cap, s->backend == SESSION_FILE ? 0 : PULL_MS);
            int err = store_write(s->store, s->batch);

            store_batch_clear(s->batch);
            if (err < 0) {
                event_add(s, 0, 0, 0, "the store could not take everything");
            }
            if (n == -ENODATA) {
                event_add(s, capture_time(s->cap), 0, 0, "the end of the file");
                capture_ended(s);
            } else if (n < 0) {
                char text[SESSION_TEXT_MAX];

                snprintf(text, sizeof(text), "the backend failed (err: %d)", n);
                event_add(s, capture_time(s->cap), 0, 0, text);
                capture_ended(s);
            }
            work = true;
        }
        s->catching_up = false;
        for (size_t i = 0; i < s->group_count; i++) {
            work = group_step(s, &s->groups[i]) || work;
        }
        if (s->store && s->items) {
            struct store_stats st;

            store_stats(s->store, &st);
            items_trim(s->items, st.oldest);
        }
        groups_publish(s);
        status_publish(s);

        if (!work) {
            struct timespec until;

            clock_gettime(CLOCK_REALTIME, &until);
            until.tv_nsec += IDLE_MS * 1000000L;
            if (until.tv_nsec >= 1000000000L) {
                until.tv_sec++;
                until.tv_nsec -= 1000000000L;
            }
            pthread_mutex_lock(&s->lock);
            if (!s->head && !s->quit) {
                pthread_cond_timedwait(&s->wake, &s->lock, &until);
            }
            pthread_mutex_unlock(&s->lock);
        }
    }

    backend_close(s);
    for (size_t i = 0; i < s->group_count; i++) {
        group_stop(&s->groups[i]);
    }
    store_batch_free(s->batch);
    s->batch = NULL;

    return NULL;
}
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
