teahaz/TH-1-MO/(commit log)

2026-03-01 Add more detailed keyboard
    [TH-A1OC_keyboard.scad, TH-A1OC_modules.scad, TH-A1OC_scratch.scad, parts.scad]
2026-03-04 Re-structuring of the PCB repositories to start work on v0.1.
    [60_percent.kicad_pcb, 60_percent.kicad_sch, keyboard.kicad_pcb, keyboard.kicad_sch]
2026-03-05 Basic power management circuit for the nrf52840 module.
    [keyboard.kicad_sch]
2026-03-06 Add USB and SWD Pogo connectors.
    These are custom symbols, the footprint for them is yet to be added.
    [keyboard.kicad_sch]
2026-03-07 Much more betterer parts
    [all.scad, framework.scad, keyboard.scad, pins.scad, screen.scad]
2026-03-07 Fix ERC errors in schematic editor
    There were a few errors with the earlier design. Both real errors and
    some just to make the ERC happy. These are fixed now, no errors and no
    warnings.
    [keyboard.kicad_sch]
2026-03-10 v2 final
    [all.scad]
2026-03-11 Re-organised the PCB part of the repository.
    Originally this repository had quite a handy structure where the kicad
    project file was in one directory, with different versions in their own
    sub dirs. This was nice to work with since all of the designs were part
    of the same kicad project.
    This may be a skill issue, but while being nice, the structure caused a
    lot of issues within kciad. The project file had to be symlinked to the
    sub directory just to make basic features work and even after that the
    PCB editor could not find the correct schematic to import symbols from.
    In the end it just makes more sense to change not abuse kicad and use it
    the default way.
    [60_percent.kicad_pcb, 60_percent.kicad_sch, keyboard.kicad_pcb, keyboard.kicad_sch]
2026-03-11 Recreated button footprint from schematic.
    The footprint for the switches have an ambiguous license. Must be
    re-created. It is still missing the 3D file.
2026-03-15 Add RF keepout zone for main chip
    [keyboard.kicad_pcb]
2026-03-15 Adjust to larger kb pcb
    [body.scad, keyboard.scad]
2026-03-17 2 layers was never going to be enough
    [keyboard.kicad_pcb, keyboard.kicad_sch]
2026-03-17 Added stp files for the nrf module and the buttons on the keyboard
    [keyboard.kicad_pcb, keyboard.kicad_sch]
2026-03-18 v3 final
    [TH-A1OC_v3.scad, body.scad, framework.scad, keyboard.scad, screen.scad]
2026-03-18 Use pX naming for prototypes instead of vX
    [TH-A1OC_all.scad, TH-A1OC_core.scad, TH-A1OC_frontplate.scad, TH-A1OC_keyboard.scad, TH-A1OC_modules.scad, TH-A1OC_scratch.scad, TH-A1OC_shell.scad, TH-A1OC_v3.scad]
2026-03-20 Complete redesign of the keyboard module
    [keyboard.kicad_pcb, keyboard.kicad_sch, keyboard_backup.kicad_pcb]
2026-03-27 Remove keyboard files
    [60_percent.kicad_pcb, 60_percent.kicad_sch, keyboard.kicad_pcb, keyboard.kicad_sch, keyboard_backup.kicad_pcb]
2026-03-27 Add license
    [TH1-MO.scad, common.scad, framework.scad]
2026-03-27 Begin p5
    [TH1.scad, body.scad, common.scad, framework.scad, keyboard.scad, screen.scad]
2026-03-28 Angular model, rear mounting positions rough measurement
    [TH1.scad, body.scad]
2026-04-11 Co-processor firmware
    This is just the basic setup for uart communication with interrupts and
    a message queue
2026-04-14 Coprocessor BLE scan (with apple & FindMy detection)
    A basic command line interface allowing for "start scan" and "stop scan"
    commands. Including listening for advertisements this code also parses
    out apple manufacturer codes and FindMy device type codes.
    In the future it should rely on a database of devices like the one
    provided by nordic semi.
2026-04-16 Add proper company ID lookup for BLE identification
    Instead of just checking for apple devices, th now uses an adapted
    version of nordic semiconductors bluetooth numbers database to lookup
    what company the bluetooth id belongs to. This list includes over 4000
    companies.
2026-05-07 Integrate IR replay into the main command interface.
    The main command interface now exposes the `ir play` command, where
    arg2 and on are interpreted as the timing values for the IR emitter.
    The timing values are specified using the flipperzero syntax, although
    for the time being the frequency and duty cycle fields are omitted since
    the are fixed values.
    [main.c]
2026-05-17 Working on the schematic for TH-1-MO prototype board.
    Currently the schematic is laid out for the IR, Logic analyser and
    co-processor subsystems. They are not yet connected the raspberry pi.
    [prototype.kicad_pcb, prototype.kicad_sch]
2026-05-17 v1 of prototype MO board
    [prototype.kicad_pcb, prototype.kicad_sch]
2026-05-21 Finish prototype circuit board
    [prototype.kicad_pcb, prototype.kicad_sch]
2026-05-27 Complete re-write of the firmware for new program select
    Implemented a new 4 wire program select + 1 wire reset system where the
    raspberry pi can put the firmware into a specific mode rather than
    issuing commands.
    Currently the IR subsystem is implemented in this mode, more to come
    when I catch up on the PCB side.
    [prototype.kicad_pcb, prototype.kicad_sch]
2026-05-27 Initial layout of motherboard components.
    Currently I've only focused on adding the main blocks, USB is
    unconnected and none of the TH specific components are added yet.
    There also are a couple chips where sourcing has not been figured out,
    they were just included in the official raspberry pi schematics.
    [coprocessor.kicad_sch, gpio.kicad_sch, high_speed.kicad_sch, mainboard.kicad_pcb, mainboard.kicad_sch]
2026-05-28 Add co processor as its own sub page
    [coprocessor.kicad_sch, gpio.kicad_sch, high_speed.kicad_sch, mainboard.kicad_sch]
2026-05-29 Add IR subsystem to schematic + clean up layout
    [coprocessor.kicad_sch, gpio.kicad_sch, high_speed.kicad_sch, mainboard.kicad_sch]
2026-06-07 Continue mainboard schematic work
    - Updated pins connecting to i2c and the co processor based on breadboard
    testing.
    - Added SD card reader
    - Added power switch
    [coprocessor.kicad_sch, gpio.kicad_sch, mainboard.kicad_sch, pinout.kicad_sch, power_system.kicad_sch]
2026-06-09 More work on the sound system
    [coprocessor.kicad_sch, gpio.kicad_sch, high_speed.kicad_sch, power_system.kicad_sch]
2026-06-10 Dac finished
    [coprocessor.kicad_sch, gpio.kicad_sch, power_system.kicad_sch]
2026-06-14 Add 3v3 regulator + reshuffle some connections.
    Regulator ported over directly from PDB. I've also had to change around
    some of the connections between modules to keep up with requirements.
    [coprocessor.kicad_sch, gpio.kicad_sch, mainboard.kicad_sch, power_system.kicad_sch]
2026-06-15 Clean up main page and power rails
    [coprocessor.kicad_sch, gpio.kicad_sch, high_speed.kicad_sch, mainboard.kicad_sch]
2026-06-16 Add high side switch to dac so its not draining power when pi is off
    [coprocessor.kicad_sch, gpio.kicad_sch, mainboard.kicad_sch]
2026-06-16 Add bypass test point to power dac if switch is not working.
    [gpio.kicad_sch]
2026-06-16 Clean up nRF power rails
    Added a ferrite bead to the power input of the nRF to isolate its noisy
    rf signals form the rest of the circuit. (especially the DAC). Also
    since this blocks some HF stuff I've added an extra 100nf capacitor
    too.
    [coprocessor.kicad_sch]
2026-06-16 Add pullup for nRESET of the nRF.
    Also re-annotated all of the symbol numbers as they were starting to get
    out of hand.
    [coprocessor.kicad_sch, gpio.kicad_sch, high_speed.kicad_sch, mainboard.kicad_sch]
2026-06-21 Base setup for FW usb ports
    The USB system is not complete yet, but all of the basics are done. The
    current limit switch, its capacitors, and usb connector parts are
    sorted.
    However, the current limit, CC pins and second port are not configured
    yet.
    [coprocessor.kicad_sch, high_speed.kicad_sch, mainboard.kicad_sch]
2026-06-21 Finish USB ports!!!
    Theoretically both the power input usb type-c port and the two host side
    ports are complete. Including a current limit IC that caps the two host
    ports at a combined 1.2A.
    ESD protection is probably still needed!!!
    [high_speed.kicad_sch]
2026-06-21 Remove the HDMI port
    We've decided there is little use to adding an HDMI port on the
    prototype if we know that it will not be present on the final board.
    [high_speed.kicad_sch]
2026-06-25 Add display connector
    The zephyr version is irrelevant now
    [high_speed.kicad_sch]
2026-06-25 Add connector for CM5
    [gpio.kicad_sch, high_speed.kicad_sch]
2026-06-25 Pinout for CM5 and co processor.
    I've tried to make the pinout expose as many different protocols as
    possible. Standard GPIO exists, but it was not a priority as I think its
    more important to have protocols for the backpack.
    The co processor also has 8 pins tied as input only. These are
    technically I/O, but they have a resistor on them which may mess up some
    output operations.
    [coprocessor.kicad_sch, gpio.kicad_sch, mainboard.kicad_sch, pinout.kicad_sch]
2026-06-26 Fix display connector wiring
    Was not linked up with the i2c and CAM_GPIO pins from the gpio page.
    [gpio.kicad_sch, mainboard.kicad_sch]
2026-06-28 High speed and Super speed ESD arrays
    [coprocessor.kicad_sch, gpio.kicad_sch, high_speed.kicad_sch, mainboard.kicad_sch, pinout.kicad_sch]
2026-06-28 Finish ESD protection.
    There are now TVS diodes/arrays on both the signal lines and power lines
    in every user accessible connector. Such as USBc ports and GPIO.
    I have not included them for internal headers, jumpers or connectors
    [coprocessor.kicad_sch, high_speed.kicad_sch, mainboard.kicad_sch, pinout.kicad_sch]
2026-06-28 Cleanup unused pins
    [coprocessor.kicad_sch, gpio.kicad_sch, high_speed.kicad_sch]
2026-06-29 Add test points
    [coprocessor.kicad_sch, gpio.kicad_sch, mainboard.kicad_sch]
2026-06-29 Make the ERC happy
    [coprocessor.kicad_sch, gpio.kicad_sch, high_speed.kicad_sch, mainboard.kicad_sch, pinout.kicad_sch]
2026-06-29 Auto re-annotate the schematic
2026-06-29 Small corrections
    [gpio.kicad_sch, high_speed.kicad_sch]
2026-06-29 Remove input only limitation on NRF pins (logic analyser)
    [coprocessor.kicad_sch, mainboard.kicad_sch, pinout.kicad_sch]
2026-06-29 Schematic draft 1 complete!!!
2026-07-01 Assigned all the footprints
    [coprocessor.kicad_sch, gpio.kicad_sch, high_speed.kicad_sch, mainboard.kicad_sch, pinout.kicad_sch]
2026-07-04 Fix footprint numbering issue linkups for pcb import
    [coprocessor.kicad_sch, gpio.kicad_sch, mainboard.kicad_pcb]
2026-07-05 Board setup and basic layout grouping
    * Added board setup settings according to JLCpcbs manufacturing minimums
    (and generous extra)
    * Grouped related components on the pcb
    [high_speed.kicad_sch, mainboard.kicad_pcb]
2026-07-09 Rough layout of the co processor
    First pass layout of where I think the components belonging to the co
    processor will go. Most of it isn't wired up yet and wont be until
    everything else has its place.
    [coprocessor.kicad_sch, mainboard.kicad_pcb, pinout.kicad_sch]
2026-07-11 Rough layout for power, SD and audio
    Added the rough layout for the power input USB port, the 3v3 regulator,
    the micro SD card and the entire audio subsystem including the dac and
    its high side switch.
    [mainboard.kicad_pcb, mainboard.kicad_sch]
2026-07-14 Initial rough layout and edge.cuts
    [mainboard.kicad_pcb]
2026-07-18 Calculated USB diff pair impedance stuff
    I am specifically committing this so it cannot get lost through any
    bugs. Nothing has actually changed on the PCB other than board setup and
    net classes.
    [mainboard.kicad_pcb]
2026-07-18 Remove USB Type-c ports + minor changes + dru file
    The current USB type-c ports aren't properly routable without using via
    in pad, which at the current stage is prohibitively expensive. I've
    removed them for now with the intent of swapping them out for ones from
    GTC.
    Additionally I noticed that a dru file has not been committed this whole
    time. Its existed for a while on my computer.
    [high_speed.kicad_sch, mainboard.kicad_pcb]
2026-07-20 USB differential pairs complete.
    Had to break these out from the rest of the pcb as they just didn't add
    up otherwise. Will continue to do the high speed lines separately before
    re assembling the pcb.
    [high_speed.kicad_sch, mainboard.kicad_pcb, mainboard.kicad_sch]
2026-07-22 Finally out of high speed hell
    Finished routing the differential pairs for the MIPI D-PHY connector.
    With that all high speed lines are completed.
    [mainboard.kicad_pcb]
2026-07-22 New rough layout
    Had to change everything up due to the requirements of the high speed
    lines. The board is now also a lot smaller
    [high_speed.kicad_sch, mainboard.kicad_pcb]
2026-07-23 High power routing
    Finished the single high power line. It should be able to hold peaks of
    5A without heating up too much, but only testing will reveal.
    [mainboard.kicad_pcb, mainboard.kicad_sch]
2026-07-25 A large chunk of the pcb routing + shrinking the board
    Did a large chunk of the PCB routing, probably just under half of all
    remaining traces. Additionally I shrank the pcb to below 100x100 as it
    reduces the price of manufacturing by roughly 4x
    [coprocessor.kicad_sch, gpio.kicad_sch, high_speed.kicad_sch, mainboard.kicad_pcb, mainboard.kicad_sch]
2026-07-27 Working on GPIO lines of the cm5
    [mainboard.kicad_pcb]
2026-07-28 Finish CM5 GPIO pinout (including DAC pins)
    [mainboard.kicad_pcb, pinout.kicad_sch]
2026-07-31 nRF wiring done
    Both the wires from the raspberry to the nRF and nRF to gpio wires done.
    That leaves only the dac and cleanup.
    [coprocessor.kicad_sch, mainboard.kicad_pcb, mainboard.kicad_sch, pinout.kicad_sch]
2026-08-03 Draft 1 PCB complete!
    [mainboard.kicad_pcb]
2026-08-06 Fixing up some DRC errors
    [coprocessor.kicad_sch, gpio.kicad_sch, mainboard.kicad_pcb, mainboard.kicad_sch]
2026-08-07 Working through the DRC errors (~200 to go)
    [mainboard.kicad_pcb]
2026-08-07 Add test harness board
    [MO_v0.1_debug_board.kicad_pcb, MO_v0.1_debug_board.kicad_sch]
2026-08-09 Shrink usb-c pins footprint to make DRC happy
    As it turns out the current usb c ports as recommended on the datasheet
    from the manufacturer are not manufacturable at jlcpcb. Shrinking the
    diameter of the drill holes fixes this, but risks the port not fitting.
    It should^tm
    Need to double check both that its manufacturable now and that it will
    actually fit the port. Need to also double check the exact spacings as
    there is less tolerance to fit with.
    [mainboard.kicad_pcb]
2026-08-21 Fix all non-clearance related DRC violations
    The clearance ones will need a little extra attention as they are
    getting quite close to the manufacturers tolerances
    [mainboard.kicad_pcb, mainboard.kicad_sch]
2026-08-22 All DRC violations cleared other than USB
    [mainboard.kicad_pcb]
2026-08-22 No more DRC!
    [mainboard.kicad_pcb]
2026-08-23 Add pintester firmware for co processor
    This small firmware file runs on the co processor to test if any of the
    BGA pins are bridged after soldering. TH does not have the funds to buy
    an x-ray, but this can at least test most of the pins. Much of the
    untestable ones (power, gnd, crystal) should be obvious if not working
    either way.
    [main.c, pinout.c, pinout.h]
2026-08-26 Clean up folder structure of the debug board
    [MO_v0.1_debug_board.kicad_pcb, MO_v0.1_debug_board.kicad_sch]
2026-08-28 Update debug board to use pi zero instead of pico
    [MO_v0.1_debug_board.kicad_pcb, MO_v0.1_debug_board.kicad_sch]
2026-08-31 Silkscreen cleanup and FAB files for MO
    [mainboard-B_Cu.gbr, mainboard-B_Mask.gbr, mainboard-B_Paste.gbr, mainboard-B_Silkscreen.gbr, mainboard-Edge_Cuts.gbr, mainboard-F_Cu.gbr, mainboard-F_Mask.gbr, mainboard-F_Paste.gbr]
2026-08-31 Clean up silkscreen and fab files for debug board
    [MO_v0.1_debug_board-B_Cu.gbr, MO_v0.1_debug_board-B_Mask.gbr, MO_v0.1_debug_board-B_Paste.gbr, MO_v0.1_debug_board-B_Silkscreen.gbr, MO_v0.1_debug_board-Edge_Cuts.gbr, MO_v0.1_debug_board-F_Cu.gbr, MO_v0.1_debug_board-F_Mask.gbr, MO_v0.1_debug_board-F_Paste.gbr]
2026-09-05 Fix: USB HS lines having gaps in the reference GND lane.
    [mainboard.kicad_pcb]
2026-09-05 Fix DRC errors in previous commit
    [mainboard.kicad_pcb]
2026-09-05 Regenerate fabrication files
    [mainboard-B_Cu.gbr, mainboard-B_Mask.gbr, mainboard-B_Paste.gbr, mainboard-B_Silkscreen.gbr, mainboard-Edge_Cuts.gbr, mainboard-F_Cu.gbr, mainboard-F_Mask.gbr, mainboard-F_Paste.gbr]
2026-10-11 Add mainboard and lib kicad files
2026-10-11 Add MO kicad files
2026-10-11 zephyr board files for the co processor
2026-10-11 Add P12 FreeCAD model and printable modules
2026-10-11 Add generic board type
    This board type is for programming the raytac nrf chip (and probably
    other nrf52840 chips) through gpio with the raspberry
2026-10-16 Add corrected P13 FreeCAD model and printable modules
2026-10-16 Add P14 CAD and assembly meshes with flush LED diffuser
2026-10-18 Publish P16 with separate puck and keyboard enclosure parts
2026-10-18 p17: Add straight-lift lids with identical rail-side screws
2026-10-18 p17: Refine key crowns and repair Framework bay corners
2026-10-19 p19: Package Nokia BL-5C with assembled and internal views
2026-10-22 p20: Publish the PCIe daughterboard prototype
2026-10-23 p20: Clean the puck interior and integrate rail screw seats
2026-10-23 p21: Refine the concealed cover and align keyboard screw mounts
2026-10-23 p22: Strengthen rail retention and preserve clear ports
2026-10-23 p22: Export assembly and print-oriented parts
2026-10-24 Update device to new channel model
    Now each channel has a read and write mode on separate pins that work
    together as a pair
2026-10-25 Bus replay schematics
